mirandali707/labububot/Labububot_ICSR_GrandChallenge.pdf

## Labububot

MIRANDA LI, (https://orcid.org/0009-0002-2278-4574) Massachusetts Institute of Technology, USA
JAKE READ, (https://orcid.org/0000-0003-4422-5837) Massachusetts Institute of Technology, USA
DIMITAR DIMITROV, (https://orcid.org/0009-0009-2547-509X) Massachusetts Institute of Technology, USA
CYNTHIA BREAZEAL, (https://orcid.org/0000-0002-0587-2065) Massachusetts Institute of Technology, USA

Abstract. Social robots are designed to be emotionally unambiguous — cute, friendly, frictionless. However, monster theory reframes the uncanny valley as productive territory. Labububot is a deliberately monstrous social robot, embedded in living popular culture and fashion. We propose that robots which provoke rather than placate may foster deeper, genuine long-term engagement. For technical details please see our Github repository: https://github.com/mirandali707/labububot.

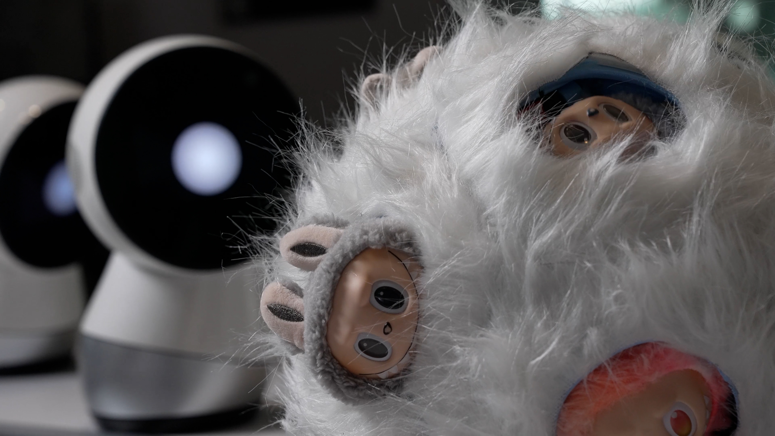
[picture p26: figure]

Fig. 1. Labububot in its natural habitat. Please see https://tinyurl.com/labububot-video for a video.

The design of social robots has strong norms: cute, or anthropomorphic, or both. Robots that look like babies are less threatening and more trustworthy [2, 6]. Anthropomorphism increases purchase intent [7], persuasiveness [1], and forgiveness [11]. But, as robots approach human-likeness, our affinity for them increases until the "uncanny valley" – a range of somewhat-but-not-quite-human features which instead trigger a distinct sense of unease [8]. The standard response to the uncanny valley is to design around it — to make robots cute enough, anthropomorphic enough, but not too much. The result is robots designed to feel frictionless: agreeable, legible, and emotionally unambiguous.
But monster theory suggests an alternative. Monster theory is an interdisciplinary field that studies monsters as cultural phenomena — not merely as fictional villains, but as symbols that reveal what a society fears, desires, and cannot categorize [3]. Scholar Jeffrey Cohen posits that a monster, by definition, resists classification, occupying spaces between human and animal, living and dead [3]. This is, of course, exactly what the uncanny valley describes [8]. The robot that triggers unease is not failing to be human — it is succeeding at being monstrous: a form that refuses easy categorization and demands engagement. Monsters are ubiquitous across cultures and throughout history precisely because they do not resolve; they are among our most durable pedagogical tools, probes for exploring complicated personal, social, and ethical questions [4, 5]. Rather than designing around

Authors’ Contact Information: Miranda Li, (https://orcid.org/0009-0002-2278-4574) m1randa@media.mit.edu, Massachusetts Institute of Technology, Cambridge, Massachusetts, USA; Jake Read, (https://orcid.org/0000-0003-4422-5837) jake.read@cba.mit.edu, Massachusetts Institute of Technology, Cambridge, Massachusetts, USA; Dimitar Dimitrov, (https://orcid.org/0009-0009-2547-509X) dsd36@mit.edu, Massachusetts Institute of Technology, Cambridge, Massachusetts, USA; Cynthia Breazeal, (https://orcid.org/0000-0002-0587-2065) cynthiab@media.mit.edu, Massachusetts Institute of Technology, Cambridge, Massachusetts, USA.

2 • Li et al.

emotional ambiguity, we might design into it instead. A robot that inhabits its own strangeness, rather than disguising it, can function not as a toy to be accepted, but as a provocation to be engaged.
Enter Labububot. Labububot takes its form from Labubu, a figure released by Pop Mart under the aptly-named product line "The Monsters". Labubu already inhabits the threshold that most social robots are designed to avoid: it is simultaneously cute and unsettling, a creature that grins with too many teeth and sits just outside the register of the purely adorable. It is also a genuine cultural phenomenon [10], circulating through global fashion culture with a resonance that no amount of engineered warmth has yet managed to produce in a social robot. Labububot takes this figure and pushes it further. Twelve Labubu heads are decapitated and reconstituted into an actuating spherical dodecahedron — an act of collage that pays deliberate homage to Frankenstein [9], that original monster assembled from parts, and that produces something categorically new: less anthropomorphic, more excessive, resistant to the affective resolution that a single cute face would provide. The design is intentionally confusing. Where conventional social robots manage affect — deploying baby schema to produce trust, compliance, and comfort — Labububot provokes it, inviting a more unsettled and therefore more reflective encounter. This is the argument made physical: Labububot is a social robot designed to lean into monstrosity. Labububot questions what social connection means, what we project onto the machines we build, and what the monsters we make reveal about the monsters we are.

Acknowledgments

Labububot was made possible by the Research@Scale research residency, organized by Cedric Honnet. We sincerely thank Jimmy Day for video production expertise. We also thank the CBA section of How To Make Almost Anything in Fall 2025 for developing an initial prototype, Neilbot, which would inspire the implementation of Labububot, and to Prof. Neil Gershenfeld.

References

[1] Elahe Abdi, Dewi Tojib, Alexander Kenwa Seong, Yamika Pamarthi, and George Millington-Palmer. 2022. A study on the influence of service robots’ level of anthropomorphism on the willingness of users to follow their recommendations. Scientific Reports 12, 1 (Sept. 2022), 15266. doi:10.1038/s41598-022-19501-0 (https://doi.org/10.1038/s41598-022-19501-0)
[2] Chien-Hsiung Chen and Xiaoyu Jia. 2023. Research on the influence of the baby schema effect on the cuteness and trustworthiness of social robot faces. International Journal of Advanced Robotic Systems 20, 3 (2023), 17298806231168486. doi:10.1177/17298806231168486 (https://doi.org/10.1177/17298806231168486) tex.eprint: https://doi.org/10.1177/17298806231168486.
[3] Jeffrey Jerome Cohen. 2007. Monster culture (seven theses). Gothic horror: A guide for students and readers (2007), 198–216.
[4] Sibylle Erle and Helen Hendry. 2020. Monsters: interdisciplinary explorations in monstrosity. Palgrave Communications 6, 1 (March 2020), 53. doi:10.1057/s41599-020-0428-1 (https://doi.org/10.1057/s41599-020-0428-1)
[5] David D Gilmore. 2012. Monsters: Evil beings, mythical beasts, and all manner of imaginary terrors. University of Pennsylvania Press.
[6] Melanie L. Glocker, Daniel D. Langleben, Kosha Ruparel, James W. Loughead, Ruben C. Gur, and Norbert Sachser. 2009. Baby Schema in Infant Faces Induces Cuteness Perception and Motivation for Caretaking in Adults. Ethology : formerly Zeitschrift fur Tierpsychologie 115, 3 (March 2009), 257–263. doi:10.1111/j.1439-0310.2008.01603.x (https://doi.org/10.1111/j.1439-0310.2008.01603.x)
[7] Yoon-Young Jung and Sowon Hahn. 2023. Social robots as companions for lonely hearts: The role of anthropomorphism and robot appearance. 2023 32nd IEEE International Conference on Robot and Human Interactive Communication (RO-MAN) (2023), 2520–2525. https://api.semanticscholar.org/CorpusID:259076046
[8] Masahiro Mori, Karl F MacDorman, and Norri Kageki. 2012. The uncanny valley [from the field]. IEEE Robotics & automation magazine 19, 2 (2012), 98–100.
[9] Mary Wollstonecraft Shelley, 1797-1851. 1998. Frankenstein, or, The modern Prometheus : the 1818 text. Oxford ; New York : Oxford University Press, 1998. https://search.library.wisc.edu/catalog/999849986102121
[10] Fan Wang and Adam Hancock. 2025. Adorable or just weird? How Labubu dolls conquered the world. https://www.bbc.com/news/articles/cy4ydxlm9n9o (https://www.bbc.com/news/articles/cy4ydxlm9n9o)
[11] Yaxin Zhao, Zhangxiang Zhu, and Binli Tang. 2025. Are highly anthropomorphic service robots more likely to be forgiven by customers after service failures? A mind perception perspective. International Journal of Hospitality Management 126 (2025), 104103. doi:10.1016/j.ijhm.2025.104103 (https://doi.org/10.1016/j.ijhm.2025.104103)
