mirandali707/labububot/images/dodecahedron.jpeg

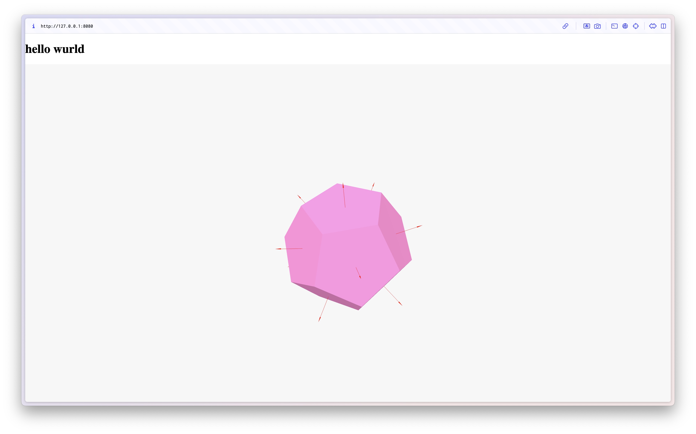
images/dodecahedron.jpeg
