mirandali707/labububot/firmware/stm32duino_accgyr.ino/stm32duino_accgyr.ino

/*
   @file    STEVAL_MEMS_FIFO_Interrupt.ino
   @author  STMicroelectronics
   @brief   Example to use the LSM6DSV16X library with FIFO status interrupts.
 *******************************************************************************
   Copyright (c) 2022, STMicroelectronics
   All rights reserved.

   This software component is licensed by ST under BSD 3-Clause license,
   the "License"; You may not use this file except in compliance with the
   License. You may obtain a copy of the License at:
                          opensource.org/licenses/BSD-3-Clause

 *******************************************************************************
*/
#include <LSM6DSV16XSensor.h>
#include <SPI.h>

#define SENSOR_ODR 104.0f // In Hertz
#define ACC_FS 2 // In g
#define GYR_FS 2000 // In dps
#define MEASUREMENT_TIME_INTERVAL (1000.0f/SENSOR_ODR) // In ms
#define FIFO_SAMPLE_THRESHOLD 199
#define FLASH_BUFF_LEN 8192
#define INT1_pin PA4 // MCU input pin connected to sensor INT1 output pin 
#define SPI_MOSI 9
#define SPI_MISO 8
#define SPI_SCK 7
#define CS_PIN 44
LSM6DSV16XSensor AccGyr(&SPI, CS_PIN);
volatile uint8_t fullFlag = 0; // FIFO full flag
uint8_t status = 0;
unsigned long timestamp_count = 0;
bool acc_available = false;
bool gyr_available = false;
int32_t acc_value[3];
int32_t gyr_value[3];
char buff[FLASH_BUFF_LEN];
uint32_t pos = 0;

void Read_FIFO_Data();

void setup()
{

  Serial.begin(115200);
  SPI.begin();

  // Initialize LSM6DSV16X.
  AccGyr.begin();
  status |= AccGyr.Enable_X();
  status |= AccGyr.Enable_G();

  // Configure ODR and FS of the acc and gyro
  status |= AccGyr.Set_X_ODR(SENSOR_ODR);
  status |= AccGyr.Set_X_FS(ACC_FS);
  status |= AccGyr.Set_G_ODR(SENSOR_ODR);
  status |= AccGyr.Set_G_FS(GYR_FS);

  // Configure FIFO BDR for acc and gyro
  status |= AccGyr.FIFO_Set_X_BDR(SENSOR_ODR);
  status |= AccGyr.FIFO_Set_G_BDR(SENSOR_ODR);

  // Set FIFO in Continuous mode
  status |= AccGyr.FIFO_Set_Mode(LSM6DSV16X_STREAM_MODE);

  if (status != LSM6DSV16X_OK) {
    Serial.println("LSM6DSV16X Sensor failed to init/configure");
    while (1);
  }
  Serial.println("LSM6DSV16X FIFO Demo");
}

void loop()
{
  uint16_t fifo_samples;

  // Check the number of samples inside FIFO
  if (AccGyr.FIFO_Get_Num_Samples(&fifo_samples) != LSM6DSV16X_OK) {
    Serial.println("LSM6DSV16X Sensor failed to get number of samples inside FIFO");
    while (1);
  }

  // If we reach the threshold we can empty the FIFO
  if (fifo_samples > FIFO_SAMPLE_THRESHOLD) {

    // Empty the FIFO
    Read_FIFO_Data();

    // Print FIFO data
    Serial.print(buff);
  }
}

void Read_FIFO_Data()
{
  uint16_t i;
  uint16_t samples_to_read;

  // Check the number of samples inside FIFO
  if (AccGyr.FIFO_Get_Num_Samples(&samples_to_read) != LSM6DSV16X_OK) {
    Serial.println("LSM6DSV16X Sensor failed to get number of samples inside FIFO");
    while (1);
  }

  for (i = 0; i < samples_to_read; i++) {
    uint8_t tag;

    // Check the FIFO tag
    if (AccGyr.FIFO_Get_Tag(&tag) != LSM6DSV16X_OK) {
      Serial.println("LSM6DSV16X Sensor failed to get tag");
      while (1);
    }
    switch (tag) {
      // If we have a gyro tag, read the gyro data
      case 1: {
          if (AccGyr.FIFO_Get_G_Axes(gyr_value) != LSM6DSV16X_OK) {
            Serial.println("LSM6DSV16X Sensor failed to get gyroscope data");
            while (1);
          }
          gyr_available = true;
          break;
        }

      // If we have an acc tag, read the acc data
      case 2: {
          if (AccGyr.FIFO_Get_X_Axes(acc_value) != LSM6DSV16X_OK) {
            Serial.println("LSM6DSV16X Sensor failed to get accelerometer data");
            while (1);
          }
          acc_available = true;
          break;
        }

      // We can discard other tags
      default: {
          break;
        }
    }
    // If we have the measurements of both acc and gyro, we can store them with timestamp
    if (acc_available && gyr_available) {
      int num_bytes;
      num_bytes = snprintf(&buff[pos], (FLASH_BUFF_LEN - pos), "%lu %d %d %d %d %d %d\r\n", (unsigned long)((float)timestamp_count * MEASUREMENT_TIME_INTERVAL), (int)acc_value[0], (int)acc_value[1], (int)acc_value[2], (int)gyr_value[0], (int)gyr_value[1], (int)gyr_value[2]);
      pos += num_bytes;
      timestamp_count++;
      acc_available = false;
      gyr_available = false;
    }
  }
  // We can add the termination character to the string, so we are ready to print it on hyper-terminal
  buff[pos] = '\0';
  pos = 0;
}
