mirandali707/labububot/firmware/sparkfun_imu_test/sparkfun_imu_test.ino

/*
  example3-spi

  This example shows the basic settings and functions for retrieving accelerometer
    and gyroscopic data but using the SPI interface. Everything other than that is
    identical to the "basic" example.

  Written by Elias Santistevan @ SparkFun Electronics, May 2022

    Products:

    SparkFun 6DoF LSM6DSV16X (Qwiic):
        https://www.sparkfun.com/products/21325

    SparkFun Micro 6DoF LSM6DSV16X (Qwiic):
        https://www.sparkfun.com/products/21336

  Repository:
        https://github.com/sparkfun/SparkFun_LSM6DSV16X_Arduino_Library

  SparkFun code, firmware, and software is released under the MIT
    License	(http://opensource.org/licenses/MIT).
*/

#include "SparkFun_LSM6DSV16X.h"
#include <SPI.h>

// SPI instance class call
SparkFun_LSM6DSV16X_SPI myLSM;

// Structs for X,Y,Z data
sfe_lsm_data_t accelData;
sfe_lsm_data_t gyroData;

// Set your chip select pin according to your setup.
int chipSelect = 44;

void setup()
{

    Serial.begin(115200);
    while (!Serial);

    Serial.println("LSM6DSV16X Example 3 - Basic Readings SPI");
    SPI.begin();
    Serial.println("SPI begun");

    pinMode(chipSelect, OUTPUT);
    digitalWrite(chipSelect, HIGH);

    if (!myLSM.begin(chipSelect))
    {
        Serial.println("Did not begin, check your wiring and/or I2C address!");
        while (1)
            ;
    }

    Serial.println("Resetting board...");
    // Reset the device to default settings. This if helpful is you're doing multiple
    // uploads testing different settings.
    myLSM.deviceReset();

    // Wait for it to finish reseting
    while (!myLSM.getDeviceReset())
    {
        delay(1);
    }

    Serial.println("Board has been Reset.");
    Serial.println("Applying settings.");

    // Accelerometer and Gyroscope registers will not be updated
    // until read.
    myLSM.enableBlockDataUpdate();

    // Set the output data rate and precision of the accelerometer
    myLSM.setAccelDataRate(LSM6DSV16X_ODR_AT_7Hz5);
    myLSM.setAccelFullScale(LSM6DSV16X_16g);

    // Set the output data rate and precision of the gyroscope
    myLSM.setGyroDataRate(LSM6DSV16X_ODR_AT_15Hz);
    myLSM.setGyroFullScale(LSM6DSV16X_2000dps);

    // Enable filter settling.
    myLSM.enableFilterSettling();

    // Turn on the accelerometer's filter and apply settings.
    myLSM.enableAccelLP2Filter();
    myLSM.setAccelLP2Bandwidth(LSM6DSV16X_XL_STRONG);

    // Turn on the gyroscope's filter and apply settings.
    myLSM.enableGyroLP1Filter();
    myLSM.setGyroLP1Bandwidth(LSM6DSV16X_GY_ULTRA_LIGHT);

    Serial.print("Ready.");
}

void loop()
{

    // Check if both gyroscope and accelerometer data is available.
    if (myLSM.checkStatus())
    {
        myLSM.getAccel(&accelData);
        myLSM.getGyro(&gyroData);
        Serial.print("Accelerometer: ");
        Serial.print("X: ");
        Serial.print(accelData.xData);
        Serial.print(" ");
        Serial.print("Y: ");
        Serial.print(accelData.yData);
        Serial.print(" ");
        Serial.print("Z: ");
        Serial.print(accelData.zData);
        Serial.println(" ");
        Serial.print("Gyroscope: ");
        Serial.print("X: ");
        Serial.print(gyroData.xData);
        Serial.print(" ");
        Serial.print("Y: ");
        Serial.print(gyroData.yData);
        Serial.print(" ");
        Serial.print("Z: ");
        Serial.print(gyroData.zData);
        Serial.println(" ");
    }

    delay(100);
}
