mirandali707/labububot/(commit log)

2026-01-10 imu test prints accel + gyro
2026-01-10 BROKEN - trying to fix SPI on esp32 but using stm32duino lib
2026-01-10 BROKEN SPI class reverted to suggestions from stm32duino LSM6DSV16X library; doesn't work with ESP32 SPI def
2026-01-10 stm32duino works! quaternion prints:
2026-01-10 added accel + gyr data printouts to stm32duino test
2026-01-11 gravity vector from stm32duino imu library
2026-01-11 receiving count over ble works (esp32 -> server); no server -> esp32 yet
2026-01-12 pca9685 pwm test
2026-01-12 sending messages from browser to ESP32 works
2026-01-12 refactored ble test browser code into ble.js for ble logic (connecting to characteristics, sending cmds etc) and ble_ui.js for ui stuff (button handlers for ble testing stuff)
2026-01-12 renamed BLESetup.cpp to lower snake case for consistency
2026-01-12 rm failed attempt at platformio, ble_test_ino -> ble_test
    [ble_setup.cpp, ble_setup.h, ble_test.ino, main.cpp]
2026-01-12 ping test works except it doesn't. setValue should not take in uint32_t -- that is truncating the timestamp. or, send something that isn't a timestamp and do the ping test a different way
    [ble_setup.cpp, ble_setup.h, ping.ino]
2026-01-14 assembly instructions
2026-01-17 servo angle for MG996R
2026-01-19 servo test code for REAL WORKING LABUBUBOT! :
2026-01-22 refactored imu code into imu lib in main pio project
2026-01-22 fine so far but servo stuff is broken.. some platformio issue, bc servo runs fine on arduino ide...
    [main.cpp, pca9685_test.ino]
2026-01-22 servo works after using adafruit servo driver lib... but i erased my entire main.cpp file lolol
2026-01-22 refactored servo code woooooo
2026-01-22 ble and servo get along
2026-01-22 servo test works, can move servos from UI -- refactored send cmd button outo f ble_ui and into index.js
2026-01-23 printing imu data works after refactorrrrrrrr
2026-01-23 imu streams to browser! and, fixed weird values bug -- was Serial.print-ing in base 4 for some reason??? silly.
    [main.cpp]
2026-01-27 dodecahedron rotates with IMU data
2026-01-27 fixed distortion - camera was using window dims, not canvas dims
2026-01-27 applying quaternion to gravity vector places it in world frame so it doesn't move and sits on POSITIVE z
2026-01-27 random servo
2026-02-15 stop + broken sweep
    [main.cpp]
2026-02-28 removed yield while Serial does not exist so we can connect to labubu wirelessly when powered on
2026-02-28 added microsecond control for the PWM which is better than set_servo_angle for sureeeeeee . also less safe yolo
2026-03-08 SERVO_TO_PWM_ID works; us and set both use bubu face ids instead of pwm ids now woohoo
2026-03-08 12 buttons for sweep bubu face
2026-03-08 roll activates bottom servo
2026-03-10 new sweep works -- (time, us pwm) tuples which use servo-specific values
2026-06-21 SERVO_ID_TO_PWM_ID is a list now, jun 20 assembled half the servos
2026-06-30 calibrate button calibrates against one face, which kind of works but not perfectly
