mirandali707/labububot/images/video_bts.jpeg

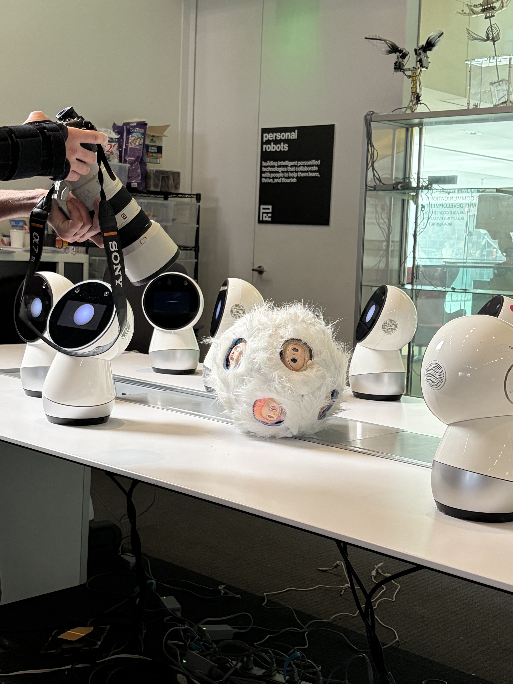
[picture p2: images/video_bts.jpeg]
images/video_bts.jpeg
