mirandali707/labububot/images/fursuit.jpeg

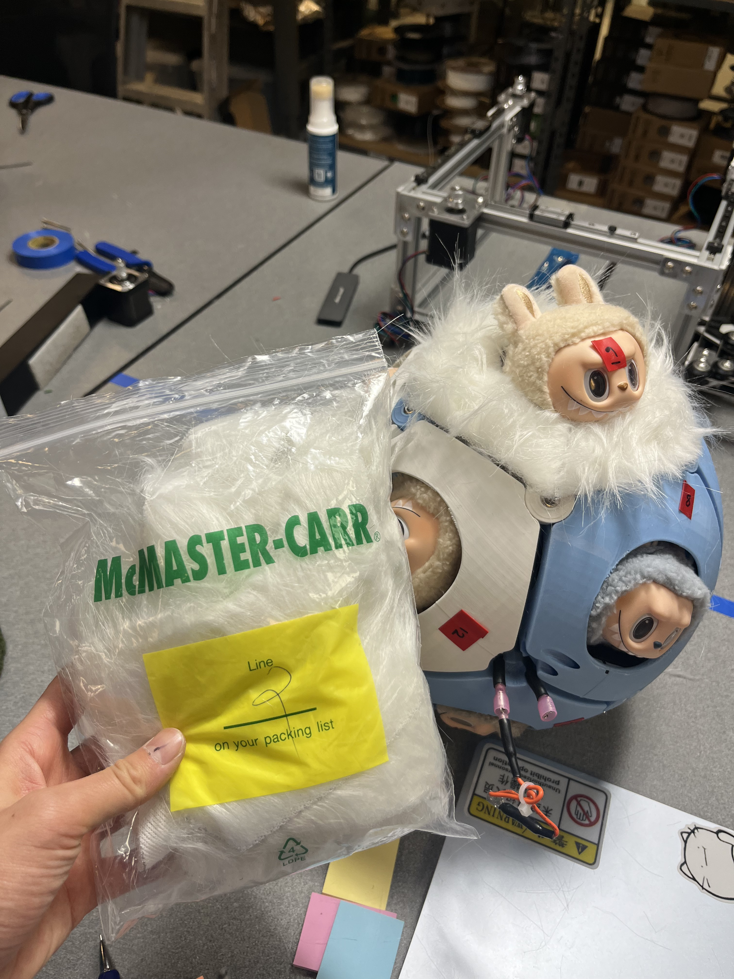
[picture p3: images/fursuit.jpeg]
images/fursuit.jpeg
